Ahmed-Osama-v5/MBR-08/README.md

# MBR-08 — Modbus RTU Relay Module

> **8-channel relay output controller with Modbus RTU slave interface, built on STM32G0B1.**  
> Designed for industrial automation, building control, and IoT gateway integration via RS-485.

---

## Table of Contents

- [Overview](#overview)
- [Hardware](#hardware)
  - [MCU](#mcu)
  - [Peripherals](#peripherals)
- [Firmware Architecture](#firmware-architecture)
  - [Layer Structure](#layer-structure)
  - [Modbus RTU Implementation](#modbus-rtU-implementation)
  - [EEPROM Driver](#eeprom-driver)
- [Modbus Register Map](#modbus-register-map)
- [Communication Parameters](#communication-parameters)
- [Build](#build--flash)
  - [Prerequisites](#prerequisites)
  - [Building with STM32CubeIDE](#building-with-stm32cubeide)
- [Configuration](#configuration)
  - [Baud Rate Selection](#baud-rate-selection)
  - [Node Address](#node-address)
- [IoT Integration Example](#iot-integration-example)
- [Project Status](#project-status)
- [License](#license)

---

## Overview

The **MBR-08** is an open-source Modbus RTU slave relay module intended for use in:

- Industrial I/O panels (RS-485 bus control)
- Smart building automation (lighting, HVAC switching)
- DIY IoT gateways (e.g., Raspberry Pi + Node-RED + InfluxDB + Grafana stack)
- Lab automation and test bench control

The firmware is written in bare-metal C, targeting the STM32G0B1CBTx, with a clean MCAL → HAL → Application layered architecture and zero direct HAL calls inside module logic (all HAL access is abstracted behind compile-time macros for portability).

---

## Hardware

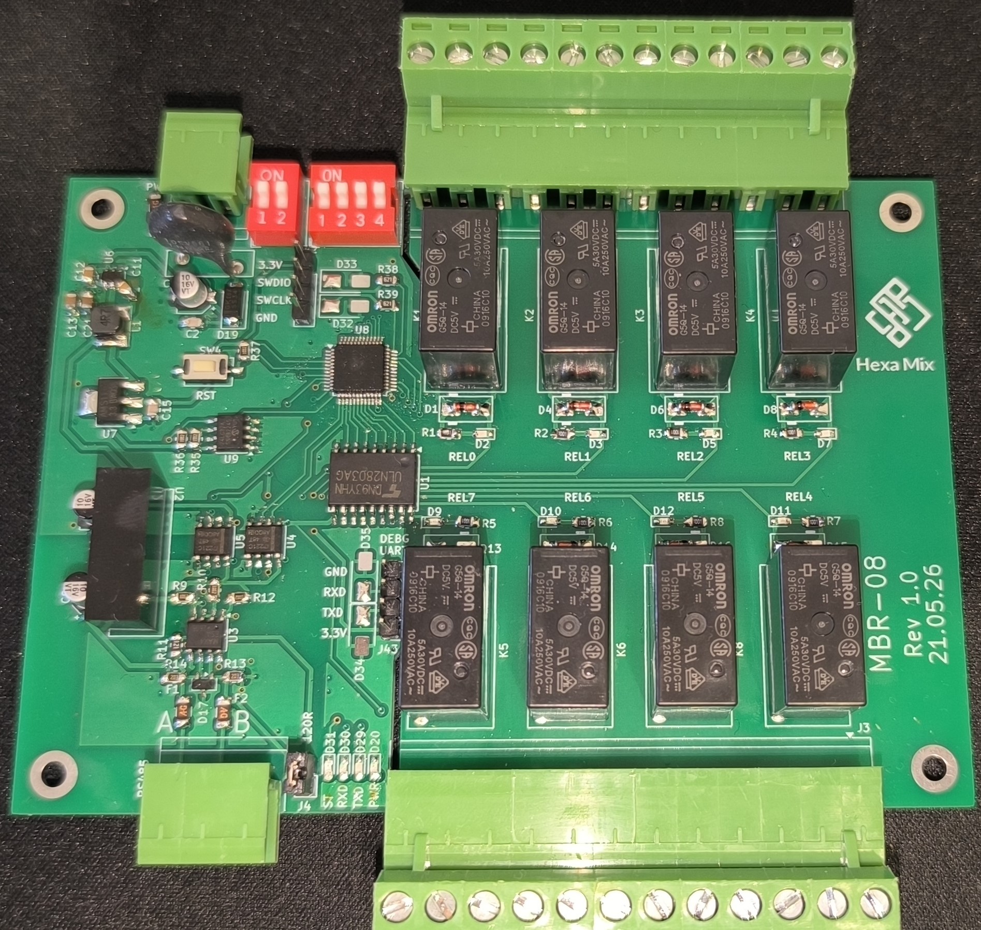
[picture p1: images/MBR-08_R1_0.jpg]
MBR-08


### MCU

| Parameter | Value |
|---|---|
| Part | STM32G0B1CBTx |
| Core | Arm Cortex-M0+, up to 64 MHz |
| Flash | 128 KB |
| RAM | 144 KB |
| Package | LQFP-48 |

### Peripherals

| Peripheral | Usage |
|---|---|
| USART1 | Modbus RTU (RS-485), configurable baud rate |
| LPTIM1 | Modbus 3.5T interframe silence detection |
| I2C1 | 24LC08 EEPROM (configuration persistence) |
| GPIO (8×) | Relay coil drive outputs |
| GPIO (n×) | Baud rate / node address DIP input pins |

---

## Firmware Architecture

### Layer Structure

```
Application (App/)
    │  Business logic: relay control
    │  Zero direct HAL calls — uses macro wrappers only
    ▼
HAL Abstraction (modbus_slave.h)
    │  modbus slave logic
    │  ...
    ▼
STM32 HAL / CMSIS (Drivers/)
    │  Generated by STM32CubeMX (.ioc file included)
    ▼
Hardware (STM32G0B1CBTx)
```

### Modbus RTU Implementation

- **Role:** Slave only
- **Interframe timing:** LPTIM1-based 3.5T detection (not software timer — accurate at all supported baud rates)
- **Supported function codes:**

  | FC   | Name                    | Direction |
  |------|-------------------------|-----------|
  | 0x01 | Read Coils              | Master → Slave (read) |
  | 0x05 | Write Single Coil       | Master → Slave (write) |
  | 0x0F | Write Multiple Coils    | Master → Slave (write) |
  | 0x03 | Read Holding Registers  | Master → Slave (read) |
  | 0x06 | Write Single Register   | Master → Slave (write) |
  | 0x10 | Write Multiple Registers   | Master → Slave (write) |

- **CRC:** Hardware-assisted or software CRC-16/IBM (Modbus polynomial `0xA001`)
- **RS-485 DE/RE:** GPIO-controlled direction pin, managed in UART TX complete callback

### EEPROM Driver

A three-file I2C EEPROM driver targets the **24LC08** (8 Kbit, 16-byte pages):

| File | Role |
|---|---|
| `i2c_eeprom_cfg.h` | Device address, page size, timeout config |
| `i2c_eeprom.h` | Public API declarations |
| `i2c_eeprom.c` | Implementation: read, write (page-aware), ACK poll |

Features:
- **Page-boundary-aware writes** — automatically splits writes that cross a 16-byte page boundary
- **ACK polling** after write cycles (no fixed delay)
- Follows the same Hungarian notation and module naming conventions used throughout the codebase

Persisted configuration includes: node address, baud rate index, relay power-on state.

---

## Modbus Register Map

### Holding Register Map 

| Address | Description | R/W | Range |
|---|---|-----|---|
| 0x0000  | Relay 1 (CH1) | R/W | 0xFF00 (Relay On), 0x0000 (Relay Off), 0xAA00 (Relay Toggle)
| 0x0001  | Relay 2 (CH2) | R/W |
| 0x0002  | Relay 3 (CH3) | R/W |
| 0x0003  | Relay 4 (CH4) | R/W |
| 0x0004  | Relay 5 (CH5) | R/W |
| 0x0005  | Relay 6 (CH6) | R/W |
| 0x0006  | Relay 7 (CH7) | R/W |
| 0x0007  | Relay 8 (CH8) | R/W |
| | | |
| 0x00FF  | All relays | R/W |
| | | |
| 0x0200  | Relay On delay (CH1) | R/W | value  * 100ms|
| 0x0201  | Relay On delay (CH2) | R/W | |
| 0x0202  | Relay On delay (CH3) | R/W | |
| 0x0203  | Relay On delay (CH4) | R/W | |
| 0x0204  | Relay On delay (CH5) | R/W | |
| 0x0205  | Relay On delay (CH6) | R/W | |
| 0x0206  | Relay On delay (CH7) | R/W | |
| 0x0207  | Relay On delay (CH8) | R/W | |
| | | |
| 0x0400  | Relay Off delay (CH1)  | R/W | value  * 100ms|
| 0x0401  | Relay Off delay (CH2)  | R/W | |
| 0x0402  | Relay Off delay (CH3)  | R/W | |
| 0x0403  | Relay Off delay (CH4)  | R/W | |
| 0x0404  | Relay Off delay (CH5)  | R/W | |
| 0x0405  | Relay Off delay (CH6)  | R/W | |
| 0x0406  | Relay Off delay (CH7)  | R/W | |
| 0x0407  | Relay Off delay (CH8)  | R/W | |
| | | |
| 0x2000  | UART parameters | R/W | TBD |
| | | |
| 0x3000  | Device address | R/W | 1 - 247 |
| | | |
| 0x4000  | Software version | R | 0x0064 = 100 = V1.00 |

---

## Communication Parameters

### Default Parameters

| Parameter | Default |
|---|---|
| Baud rate | 9600 bps |
| Data bits | 8 |
| Parity | None |
| Stop bits | 1 |
| Node address | 1 |

### Supported Baud Rates

| Index | Baud Rate  |
|---|---|
| 0 | 1200 |
| 1 | 2400 |
| 2 | 4800 |
| 3 | 9600 |
| 4 | 19200 |
| 5 | 38400 |
| 6 | 57600 |
| 7 | 115200 |

Baud rate is selected via GPIO input pins on boot (hardware DIP switches) and stored in EEPROM. Register-based runtime change is also supported (takes effect after reset).

---

## Build

### Prerequisites

| Tool | Version tested |
|---|---|
| STM32CubeIDE | 2.1.1 |
| STM32CubeMX | 6.17.0 (`.ioc` included) |
| arm-none-eabi-gcc | 10.3.1 |
| ST-Link V2 / V3 | Any |

### Building with STM32CubeIDE

```bash
# Clone the repository
git clone https://github.com/Ahmed-Osama-v5/MBR-08.git
cd MBR-08

# Open in STM32CubeIDE: File → Open Projects from File System
# Select the repo root directory
# Build: Project → Build All  (or Ctrl+B)
```

The `.cproject` and `.project` Eclipse CDT files are included. The build produces `MBR-08.elf` and `MBR-08.bin` under `Debug/` or `Release/`.

## Configuration

### Baud Rate Selection

Baud rate is read from dedicated GPIO input pins on startup. Pull the pins LOW/HIGH according to the baud rate index table above. The value is latched once during `Modbus_Init()` and written to EEPROM if changed (requires reset to take effect).

## IoT Integration Example

The MBR-08 has been validated against a **Raspberry Pi 5** acting as Modbus RTU master and IoT gateway:

```
[MBR-08] ←── RS-485 ──→ [USB-RS485 adapter] ──→ [RPi 5]
                                                      │
                                              Node-RED (Modbus TCP/RTU)
                                                      │
                                              InfluxDB 2.x
                                              (org: HexaMix, bucket: relay_states)
                                                      │
                                              Grafana Dashboard
```

Node-RED `node-red-contrib-modbus` nodes can poll coil states and write relay outputs directly. InfluxDB line protocol logging provides historical state tracking per channel.

---

## Project Status

| Area | Status |
|---|---|
| Firmware — Core Modbus RTU  | ✅ Complete |
| Firmware — EEPROM driver | ✅ Complete |
| Firmware — HAL abstraction macros | ✅ Complete |
| PCB — KiCad layout (BASE_8CH) | ✅ Complete |
| Unit tests | 📋 Planned |
| Hardware bring-up / validation | ✅ Complete |

---

## License

This project is dual-licensed:

- **Open-source use:** [GNU General Public License v3.0](LICENSE) — see `GPL-3.0.txt`
- **Commercial / proprietary use:** Contact the author for a commercial license

Third-party components (STM32 HAL, CMSIS) retain their original ST Microelectronics licenses as included in the `Drivers/` directory.

---

*Maintained by [Ahmed Osama](https://github.com/Ahmed-Osama-v5)*
