Ahmed-Osama-v5/MBR-08/MBR-08_sch.pdf

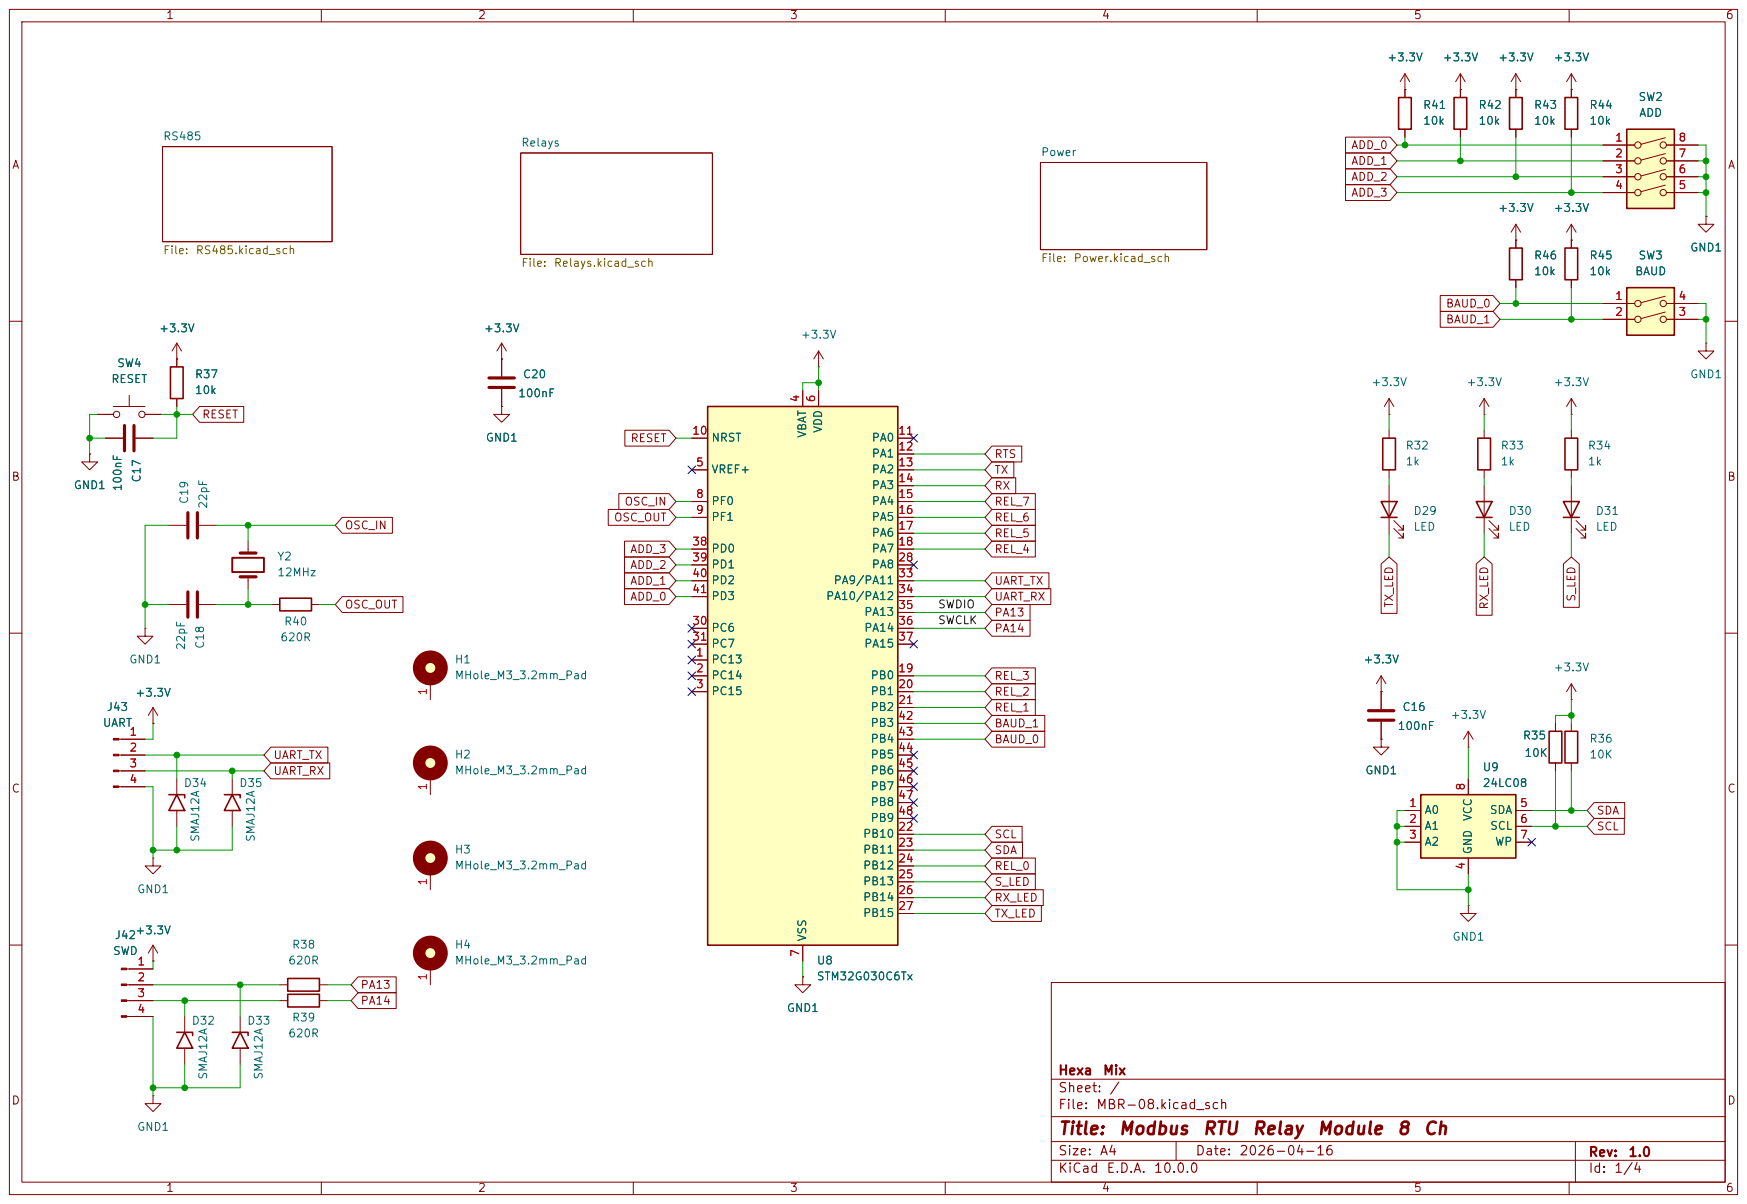
[picture p2: page 1]

Power File: Power.kicad_sch Relays

Hexa Mix
Sheet: /
D Date: 2026-04-16 KiCad E.D.A. 10.0.0
File: MBR-08.kicad_sch
Title: Modbus RTU Relay Module 8 Ch

Size: A4 | Rev: 1.0

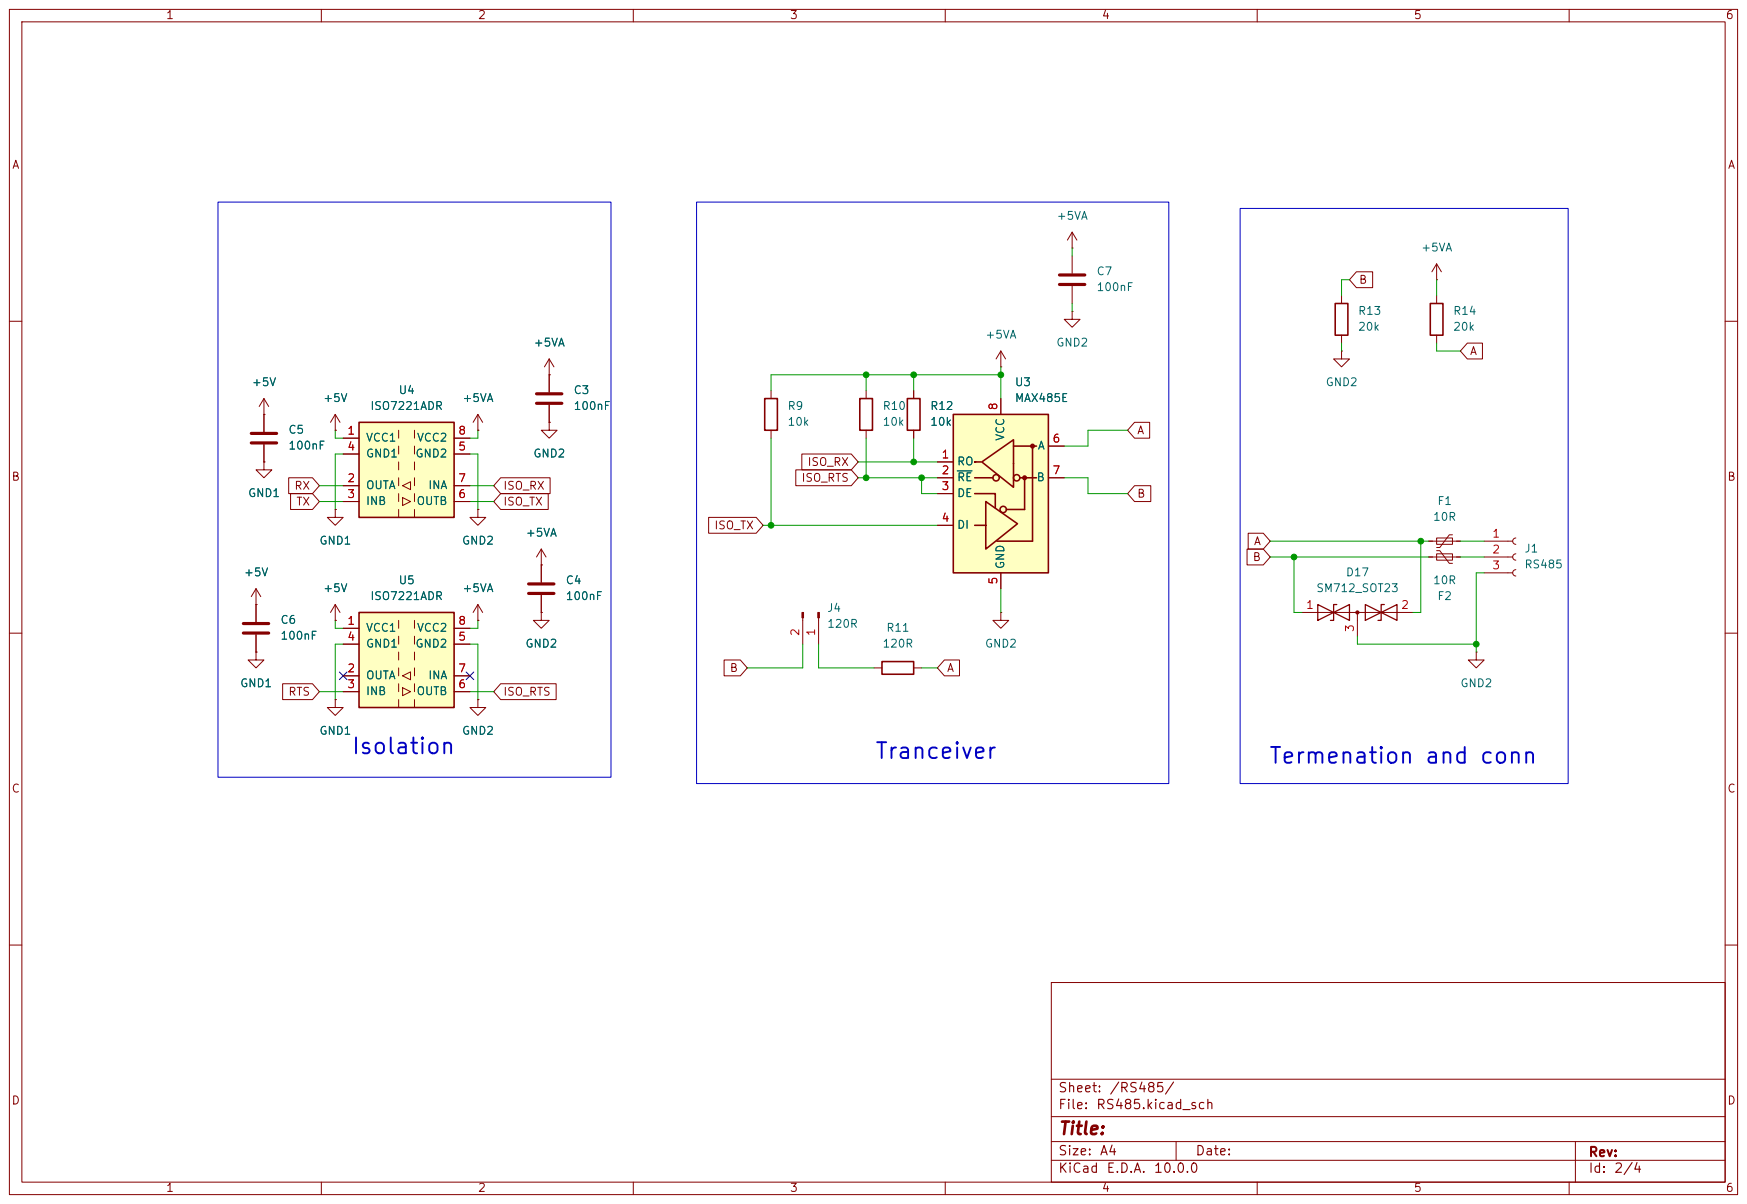
[picture p3: page 2]

Size: A4 | Rev:
KiCad E.D.A. 10.0.0

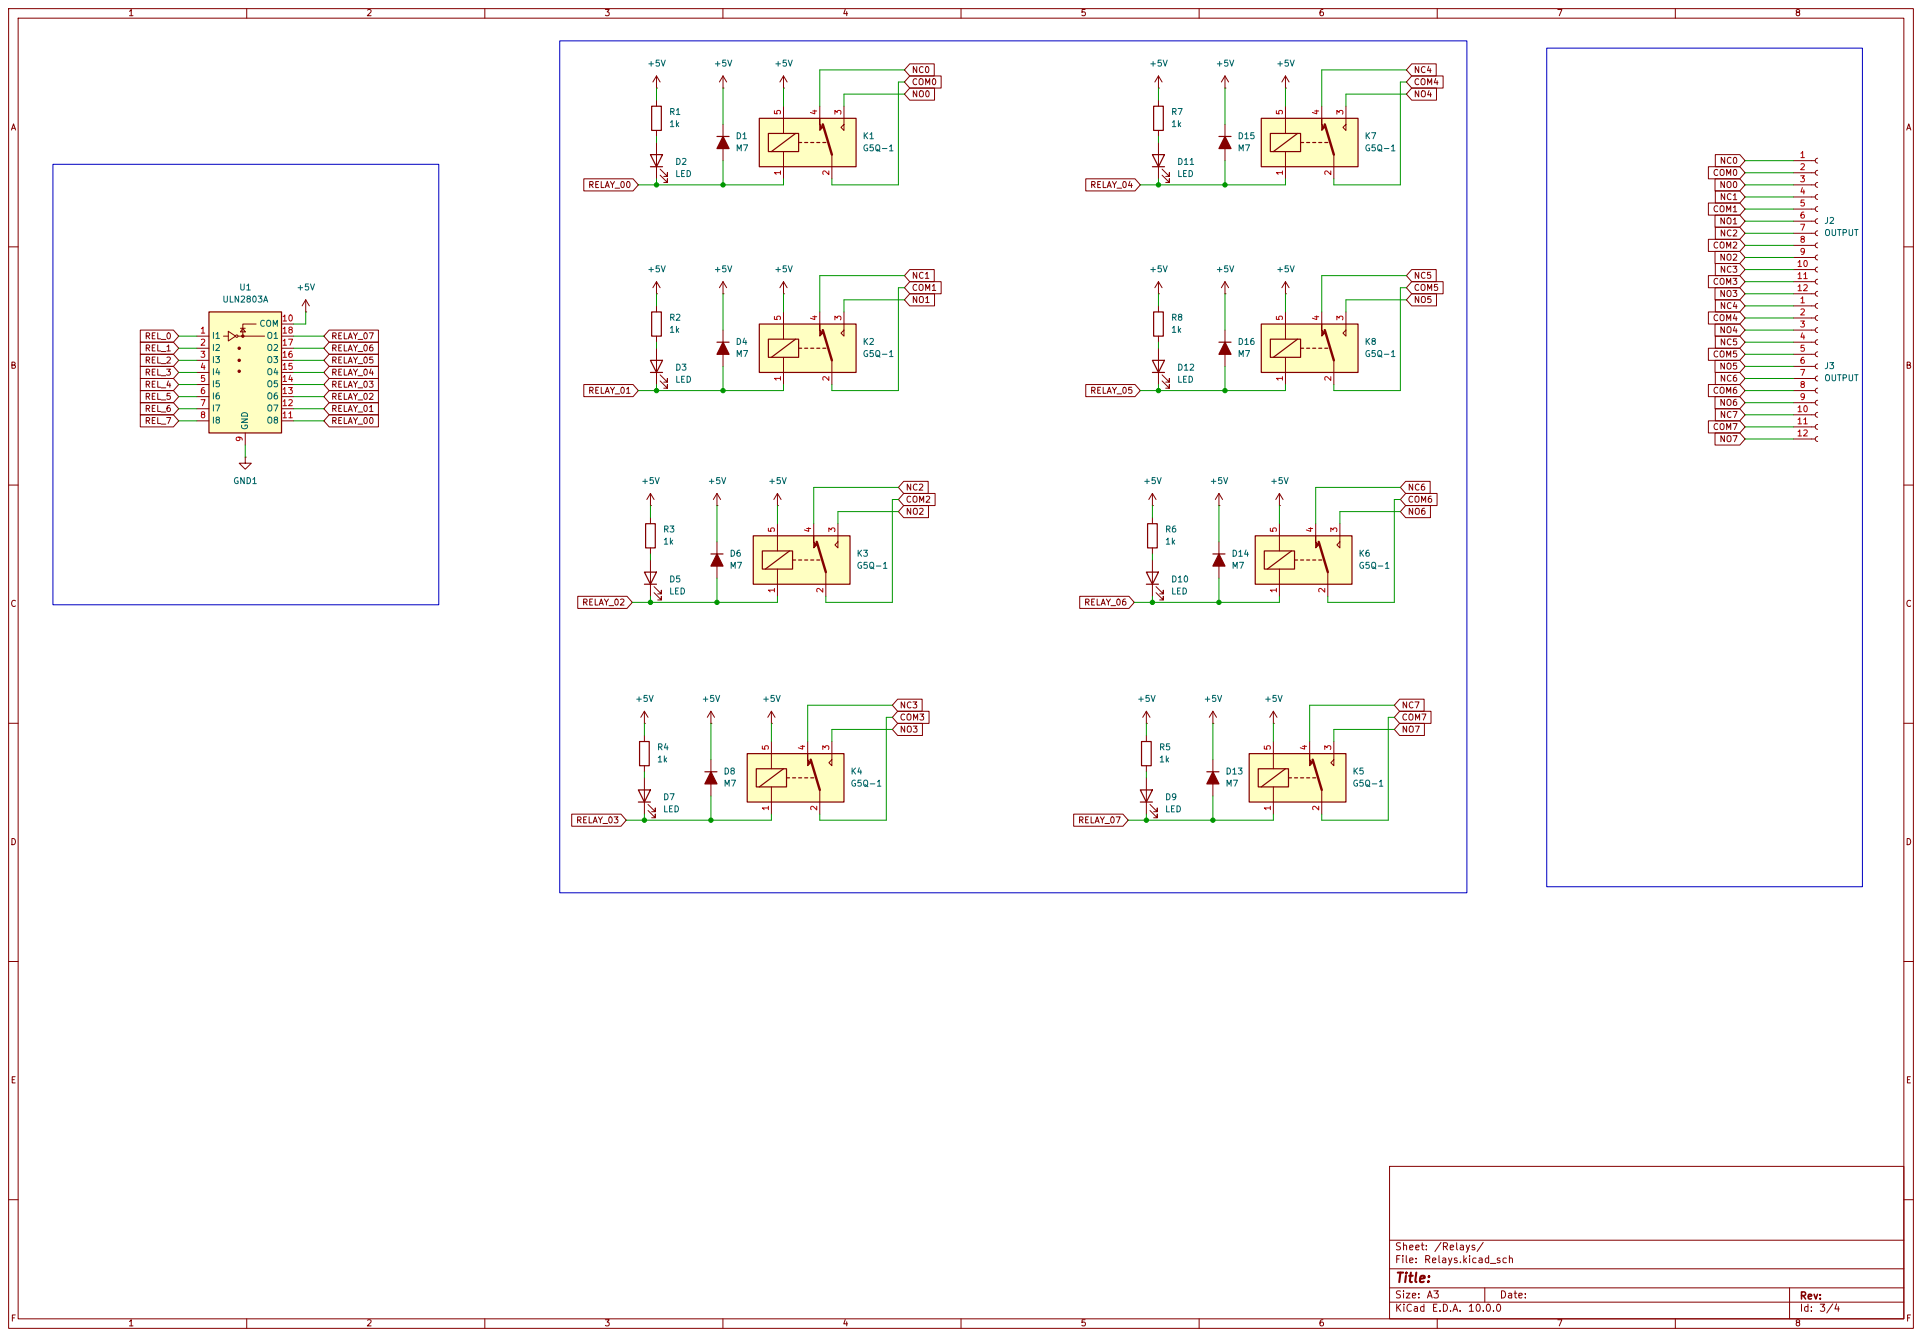
[picture p4: page 3]

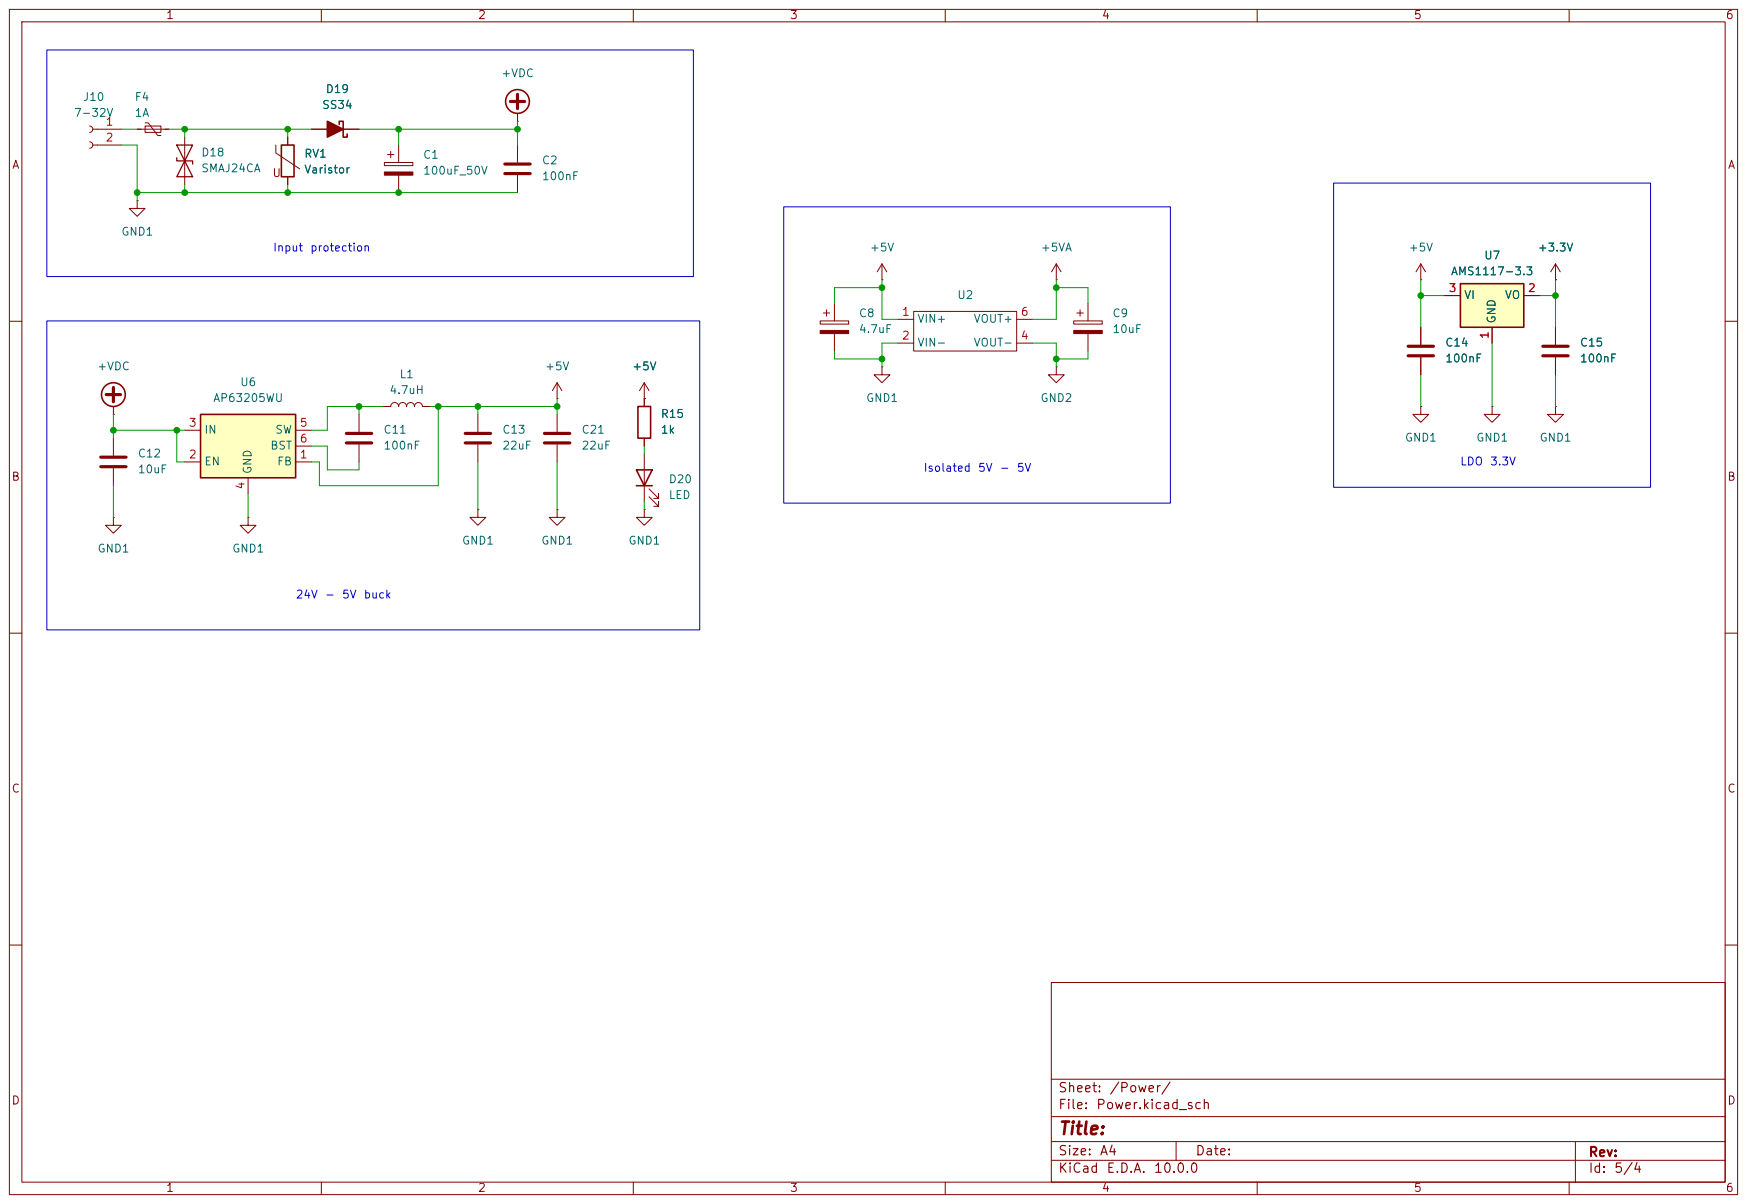
[picture p5: page 4]
