Ahmed-Osama-v5/MBR-08/Core/Src/main.c

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
/* Includes ------------------------------------------------------------------*/
#include "main.h"

/* USER CODE BEGIN Includes */
#include <stdbool.h>
#include "scheduler.h"
#include "modbus_slave.h"
/* USER CODE END Includes */

I2C_HandleTypeDef hi2c2;

IWDG_HandleTypeDef hiwdg;

TIM_HandleTypeDef htim2;

UART_HandleTypeDef huart1;
UART_HandleTypeDef huart2;

/* USER CODE BEGIN PV */

/* struct that holds all relay control registers */
extern Regs_t regsRelCon;

/* flag to indicate new data reception */
bool bNewData = true;
/* USER CODE END PV */

void SystemClock_Config(void);
static void MX_GPIO_Init(void);
static void MX_I2C2_Init(void);
static void MX_USART1_UART_Init(void);
static void MX_USART2_UART_Init(void);
static void MX_IWDG_Init(void);
static void MX_TIM2_Init(void);
/* USER CODE BEGIN PFP */

static void Task_RelayUpdate(void);
static void Task_ActLED(void);
/* USER CODE END PFP */

/**
  * @brief  The application entry point.
  * @retval int
  */
int main(void)
{

  /* MCU Configuration--------------------------------------------------------*/

  /* Reset of all peripherals, Initializes the Flash interface and the Systick. */
  HAL_Init();

  /* Configure the system clock */
  SystemClock_Config();

  /* Initialize all configured peripherals */
  MX_GPIO_Init();
  MX_I2C2_Init();
  MX_USART1_UART_Init();
  MX_USART2_UART_Init();
  MX_IWDG_Init();
  MX_TIM2_Init();
  /* USER CODE BEGIN 2 */
  Scheduler_Init();
  Modbus_Init();

  /* Turn TX led off */
  HAL_GPIO_WritePin(TX_LED_GPIO_Port, TX_LED_Pin, GPIO_PIN_SET);

  /* Turn RX led off */
  HAL_GPIO_WritePin(RX_LED_GPIO_Port, RX_LED_Pin, GPIO_PIN_SET);

  /* Note: Modbus has no tasks in the scheduler because it's all run through interrupts */
  Scheduler_AddTask(Task_RelayUpdate,     5U,   50U);  /* every 5ms,  stuck if >50ms  */
  Scheduler_AddTask(Task_ActLED,  500U,    0U);  /* every 500ms, not wdog-guarded */


  uint8_t msg[] = "Start scheduler\r\n";
  HAL_UART_Transmit(&huart1, msg, sizeof(msg) - 1, HAL_MAX_DELAY);
  /* USER CODE END 2 */

  /* Infinite loop */
  /* USER CODE BEGIN WHILE */
  while (1)
  {
	  Scheduler_Run();
    /* USER CODE END WHILE */

    /* USER CODE BEGIN 3 */
  }
  /* USER CODE END 3 */
}

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
/* USER CODE BEGIN 4 */

/* Mirrors g_relay_coils bitmask to 8 GPIO relay outputs */
static void Task_RelayUpdate(void)
{
	if(bNewData)
	{
		for (uint8_t ch = 0U; ch < MB_NUM_COILS; ch++) {
			GPIO_PinState state = (regsRelCon.pRegs[ch]->u16Data == cu16_RELAY_ON) ? GPIO_PIN_SET : GPIO_PIN_RESET;

			switch (ch) {
				case 0: HAL_GPIO_WritePin(REL_0_GPIO_Port, REL_0_Pin, state); break;
				case 1: HAL_GPIO_WritePin(REL_1_GPIO_Port, REL_1_Pin, state); break;
				case 2: HAL_GPIO_WritePin(REL_2_GPIO_Port, REL_2_Pin, state); break;
				case 3: HAL_GPIO_WritePin(REL_3_GPIO_Port, REL_3_Pin, state); break;
				case 4: HAL_GPIO_WritePin(REL_4_GPIO_Port, REL_4_Pin, state); break;
				case 5: HAL_GPIO_WritePin(REL_5_GPIO_Port, REL_5_Pin, state); break;
				case 6: HAL_GPIO_WritePin(REL_6_GPIO_Port, REL_6_Pin, state); break;
				case 7: HAL_GPIO_WritePin(REL_7_GPIO_Port, REL_7_Pin, state); break;
				default: break;
			}
		}
	}
	bNewData = false;

}

static void Task_ActLED(void)
{
    HAL_GPIO_TogglePin(ACT_LED_GPIO_Port, ACT_LED_Pin);
}

/**
 * @brief UART RX complete — fires for every received byte.
 */
void HAL_UART_RxCpltCallback(UART_HandleTypeDef *huart)
{
    if (huart->Instance == USART2)
    {
        /* s_rxBuf[s_rxLen-1] already written by HAL into the pointer we gave.
           We need to extract the last byte — simplest: keep a shadow byte.   */
        extern uint8_t g_lastRxByte;   /* defined in modbus_slave.c below    */
        Modbus_RxByteCallback(g_lastRxByte);
    }
}

/**
 * @brief TIM2 period elapsed — 3.5T silence detected.
 */
void HAL_TIM_PeriodElapsedCallback(TIM_HandleTypeDef *htim)
{
	if (htim->Instance == TIM2)
	{
		ModbusTimer_FrameDoneCallback();
	}
}

/* USER CODE END 4 */
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
