Ahmed-Osama-v5/MBR-08/Core/Inc/main.h

#define cu16SOFTWARE_VERSION	((uint16_t) 100u)
#define MODBUS_UART_CH	huart2
#define MODBUS_TIMER_CH	htim2
#define RX_EN_Pin GPIO_PIN_1
#define RX_EN_GPIO_Port GPIOA
#define REL_7_Pin GPIO_PIN_4
#define REL_7_GPIO_Port GPIOA
#define REL_6_Pin GPIO_PIN_5
#define REL_6_GPIO_Port GPIOA
#define REL_5_Pin GPIO_PIN_6
#define REL_5_GPIO_Port GPIOA
#define REL_4_Pin GPIO_PIN_7
#define REL_4_GPIO_Port GPIOA
#define REL_3_Pin GPIO_PIN_0
#define REL_3_GPIO_Port GPIOB
#define REL_2_Pin GPIO_PIN_1
#define REL_2_GPIO_Port GPIOB
#define REL_1_Pin GPIO_PIN_2
#define REL_1_GPIO_Port GPIOB
#define REL_0_Pin GPIO_PIN_12
#define REL_0_GPIO_Port GPIOB
#define ACT_LED_Pin GPIO_PIN_13
#define ACT_LED_GPIO_Port GPIOB
#define RX_LED_Pin GPIO_PIN_14
#define RX_LED_GPIO_Port GPIOB
#define TX_LED_Pin GPIO_PIN_15
#define TX_LED_GPIO_Port GPIOB
#define ADD_3_Pin GPIO_PIN_0
#define ADD_3_GPIO_Port GPIOD
#define ADD_2_Pin GPIO_PIN_1
#define ADD_2_GPIO_Port GPIOD
#define ADD_1_Pin GPIO_PIN_2
#define ADD_1_GPIO_Port GPIOD
#define ADD_0_Pin GPIO_PIN_3
#define ADD_0_GPIO_Port GPIOD
#define BAUD_1_Pin GPIO_PIN_3
#define BAUD_1_GPIO_Port GPIOB
#define BAUD_0_Pin GPIO_PIN_4
#define BAUD_0_GPIO_Port GPIOB
