Ahmed-Osama-v5/MBR-08/Core/Src/modbus_slave.c

/**
 *
 * Copyright (C) 2026 HexaMix
 * SPDX-License-Identifier: GPL-3.0-only
 * Dual-licensed — see LICENSE for commercial use.
 *
 * @file    modbus_slave.c
 * @brief   Minimal Modbus RTU Slave — STM32G0B1CB
 *
 * Supported Function Codes:
 *   0x01 — Read Coils            (coils 0..7 )
 *   0x05 — Write Single Coil
 *   0x0F — Write Multiple Coils
 *   0x03 — Read Holding Registers (regs 0..7, shadow of coils)
 *   0x06 — Write Single Register
 *   0x10 — Write Multiple Registers
 *
 * Frame flow:
 *   UART RX byte → Modbus_RxByteCallback() → buffer + restart timer
 *   timer fires  → Modbus_TimerCallback()  → process frame → send response
 */

#include <stdio.h>
#include <string.h>
#include <stdbool.h>
#include "modbus_slave.h"
#include "i2c_eeprom.h"

#define _DEBUG


extern UART_HandleTypeDef huart1;

/* ── Coils status ───────────────────────────────────────────────────────── */
Coil_Status_t str_CoilStates;
extern bool bNewData;

/* ── Modbus exception codes ─────────────────────────────────────────────── */
#define MB_EX_ILLEGAL_FUNCTION      0x01u
#define MB_EX_ILLEGAL_DATA_ADDRESS  0x02u
#define MB_EX_ILLEGAL_DATA_VALUE    0x03u


/* ── Holding registers ───────────────────────────────────────────────────── */
/* Relay channels */
/* 0x0000 - 0x0007 channels 0..7
 * Permission: R/W
 * Functions: 0x01, 0x05, 0x0F
 * Values:
 * 0xFF00: relay on
 * 0x0000: relay off
 * 0xAA00: relay toggle
 * */
Reg_t regRelayCon0;
Reg_t regRelayCon1;
Reg_t regRelayCon2;
Reg_t regRelayCon3;
Reg_t regRelayCon4;
Reg_t regRelayCon5;
Reg_t regRelayCon6;
Reg_t regRelayCon7;

/* struct that holds all relay control registers */
Regs_t regsRelCon;

/* 0x00FF controls all relays
 * Permission: W
 * Functions: 0x05
 * Values:
 * 0xFF00: all relays on
 * 0x0000: all relays off
 * 0xAA00: all relays toggle
 * */
Reg_t regRelayConAll;

/* 0x0200 - 0x0207 relay on delay
 * Permission: W
 * Functions: 0x05
 * Values:
 * 0x0005: 5 * 100ms
 * */
Reg_t regRelayDelOn0;
Reg_t regRelayDelOn1;
Reg_t regRelayDelOn2;
Reg_t regRelayDelOn3;
Reg_t regRelayDelOn4;
Reg_t regRelayDelOn5;
Reg_t regRelayDelOn6;
Reg_t regRelayDelOn7;

/* struct that holds all relay on delay registers */
Regs_t regsRelDelOn;

/* 0x0400 - 0x407 relay off delay
 * Permission: W
 * Functions: 0x05
 * Values:
 * 0x0005: 5 * 100ms
 * */
Reg_t regRelayDelOff0;
Reg_t regRelayDelOff1;
Reg_t regRelayDelOff2;
Reg_t regRelayDelOff3;
Reg_t regRelayDelOff4;
Reg_t regRelayDelOff5;
Reg_t regRelayDelOff6;
Reg_t regRelayDelOff7;

/* struct that holds all relay off delay registers */
Regs_t regsRelDelOff;

/* 0x2000 UART parameters
 * Permission: R/W
 * Functions: 0x03, 0x06
 * Values:
 * The high eight bits indicate the parity mode: 0x00~0x02
 * The low eight bits indicate the baud rate mode: 0x00~0x07
 * */
Reg_t regUART_Param;

/* 0x3000 Device address
 * Permission: R/W
 * Functions: 0x03, 0x06
 * Values:
 * Directly store Modbus address
 * Device address: 0x0001-0x00F7
 * Based on DIP switch config:
 * 0000: defaults to memory stored address (default: 0x01)
 * 0001 - 1111 : address: 0x01 - 0x0F
 * */
Reg_t regDevAdd;

/* 0x4000 Software version
 * Permission: R
 * Functions: 0x03
 * Values:
 * Converting to decimal and then shifting the decimal point
 * two places to the left will represent the software version
 * 0x0064 = 100 = V1.00
 * refer to cu16SOFTWARE_VERSION in main.h
 * */
Reg_t regSWVer;



/* ── internal state ─────────────────────────────────────────────────────── */

static uint8_t  s_rxBuf[MB_RX_BUF_SIZE];
static uint16_t s_rxLen;
       uint8_t  g_lastRxByte;   /* HAL writes here; exposed to main.c       */
static uint8_t  s_txBuf[MB_TX_BUF_SIZE];

int __io_putchar(int ch)
{
    HAL_UART_Transmit(&huart1, (uint8_t *)&ch, 1, HAL_MAX_DELAY);
    return ch;
}


/* ── CRC-16 (Modbus polynomial 0xA001) ─────────────────────────────────── */
static uint16_t crc16(const uint8_t *buf, uint16_t len)
{
    uint16_t crc = 0xFFFFu;
    for (uint16_t i = 0u; i < len; i++)
    {
        crc ^= (uint16_t)buf[i];
        for (uint8_t b = 0u; b < 8u; b++)
        {
            if (crc & 0x0001u)
                crc = (crc >> 1u) ^ 0xA001u;
            else
                crc >>= 1u;
        }
    }
    return crc;
}

/* ── response helpers ───────────────────────────────────────────────────── */
static void sendResponse(uint16_t len)
{
	/* Turn TX led on */
	HAL_GPIO_WritePin(TX_LED_GPIO_Port, TX_LED_Pin, GPIO_PIN_RESET);

    uint16_t crc = crc16(s_txBuf, len);
    s_txBuf[len]     = (uint8_t)(crc & 0xFFu);         /* CRC low           */
    s_txBuf[len + 1u] = (uint8_t)((crc >> 8u) & 0xFFu); /* CRC high         */
    RS485_DE_HIGH();   // ← assert DE/RE before TX
    //HAL_UART_Transmit_IT(MODBUS_UART_HANDLE, s_txBuf, len + 2u);
    HAL_UART_Transmit_IT(&huart2, s_txBuf, len + 2u);
}

static void sendException(uint8_t fc, uint8_t exCode)
{
    s_txBuf[0] = regDevAdd.u16Data;
    s_txBuf[1] = fc | 0x80u;
    s_txBuf[2] = exCode;
    sendResponse(3u);
}

static bool bIsAddValid(uint16_t regAdd)
{
	if((regAdd == cu16RELAY_CON_CH_0_ADD)
			|| (regAdd == cu16RELAY_CON_CH_1_ADD)
			|| (regAdd == cu16RELAY_CON_CH_2_ADD)
			|| (regAdd == cu16RELAY_CON_CH_3_ADD)
			|| (regAdd == cu16RELAY_CON_CH_4_ADD)
			|| (regAdd == cu16RELAY_CON_CH_5_ADD)
			|| (regAdd == cu16RELAY_CON_CH_6_ADD)
			|| (regAdd == cu16RELAY_CON_CH_7_ADD)
			|| (regAdd == cu16RELAY_CON_ALL_ADD)
			|| (regAdd == cu16RELAY_ON_DELAY_CH_0_ADD)
			|| (regAdd == cu16RELAY_ON_DELAY_CH_1_ADD)
			|| (regAdd == cu16RELAY_ON_DELAY_CH_2_ADD)
			|| (regAdd == cu16RELAY_ON_DELAY_CH_3_ADD)
			|| (regAdd == cu16RELAY_ON_DELAY_CH_4_ADD)
			|| (regAdd == cu16RELAY_ON_DELAY_CH_5_ADD)
			|| (regAdd == cu16RELAY_ON_DELAY_CH_6_ADD)
			|| (regAdd == cu16RELAY_ON_DELAY_CH_7_ADD)
			|| (regAdd == cu16RELAY_OFF_DELAY_CH_0_ADD)
			|| (regAdd == cu16RELAY_OFF_DELAY_CH_1_ADD)
			|| (regAdd == cu16RELAY_OFF_DELAY_CH_2_ADD)
			|| (regAdd == cu16RELAY_OFF_DELAY_CH_3_ADD)
			|| (regAdd == cu16RELAY_OFF_DELAY_CH_4_ADD)
			|| (regAdd == cu16RELAY_OFF_DELAY_CH_5_ADD)
			|| (regAdd == cu16RELAY_OFF_DELAY_CH_6_ADD)
			|| (regAdd == cu16RELAY_OFF_DELAY_CH_7_ADD)
			|| (regAdd == cu16UART_PARAM_ADD)
			|| (regAdd == cu16DEVICE_ADDRESS_ADD)
			|| (regAdd == cu16SOFTWARE_VERSION_ADD))
	{
		return true;
	}
	return false;
}

/**
 * @brief iterates through register addresses
 * and returns pointer to required register address
 * @param u16Addr
 * @return (Reg_t*) pointer to required register address
 */
static Reg_t* pFindReg(uint16_t u16Addr)
{
	if(u16Addr == cu16RELAY_CON_CH_0_ADD)
		return &regRelayCon0;
	else if(u16Addr == cu16RELAY_CON_CH_1_ADD)
		return &regRelayCon1;
	else if(u16Addr == cu16RELAY_CON_CH_2_ADD)
		return &regRelayCon2;
	else if(u16Addr == cu16RELAY_CON_CH_3_ADD)
		return &regRelayCon3;
	else if(u16Addr == cu16RELAY_CON_CH_4_ADD)
		return &regRelayCon4;
	else if(u16Addr == cu16RELAY_CON_CH_5_ADD)
		return &regRelayCon5;
	else if(u16Addr == cu16RELAY_CON_CH_6_ADD)
		return &regRelayCon6;
	else if(u16Addr == cu16RELAY_CON_CH_7_ADD)
		return &regRelayCon7;

	else if(u16Addr == cu16RELAY_CON_ALL_ADD)
		return &regRelayConAll;

	else if(u16Addr == cu16RELAY_ON_DELAY_CH_0_ADD)
		return &regRelayDelOn0;
	else if(u16Addr == cu16RELAY_ON_DELAY_CH_1_ADD)
		return &regRelayDelOn1;
	else if(u16Addr == cu16RELAY_ON_DELAY_CH_2_ADD)
		return &regRelayDelOn2;
	else if(u16Addr == cu16RELAY_ON_DELAY_CH_3_ADD)
		return &regRelayDelOn3;
	else if(u16Addr == cu16RELAY_ON_DELAY_CH_4_ADD)
		return &regRelayDelOn4;
	else if(u16Addr == cu16RELAY_ON_DELAY_CH_5_ADD)
		return &regRelayDelOn5;
	else if(u16Addr == cu16RELAY_ON_DELAY_CH_6_ADD)
		return &regRelayDelOn6;
	else if(u16Addr == cu16RELAY_ON_DELAY_CH_7_ADD)
		return &regRelayDelOn7;

	else if(u16Addr == cu16RELAY_OFF_DELAY_CH_0_ADD)
		return &regRelayDelOff0;
	else if(u16Addr == cu16RELAY_OFF_DELAY_CH_1_ADD)
		return &regRelayDelOff1;
	else if(u16Addr == cu16RELAY_OFF_DELAY_CH_2_ADD)
		return &regRelayDelOff2;
	else if(u16Addr == cu16RELAY_OFF_DELAY_CH_3_ADD)
		return &regRelayDelOff3;
	else if(u16Addr == cu16RELAY_OFF_DELAY_CH_4_ADD)
		return &regRelayDelOff4;
	else if(u16Addr == cu16RELAY_OFF_DELAY_CH_5_ADD)
		return &regRelayDelOff5;
	else if(u16Addr == cu16RELAY_OFF_DELAY_CH_6_ADD)
		return &regRelayDelOff6;
	else if(u16Addr == cu16RELAY_OFF_DELAY_CH_7_ADD)
		return &regRelayDelOff7;

	else if(u16Addr == cu16UART_PARAM_ADD)
		return &regUART_Param;

	else if(u16Addr == cu16DEVICE_ADDRESS_ADD)
		return &regDevAdd;

	else
		return NULL;
}

#if 0
static uint16_t u16GetRegEE_Addr(const Reg_t* pReg)
{
	uint16_t u16RetVal = 0x00FF;

	if(pReg == &regUART_Param)
		u16RetVal = cu16UART_PARAM_EE_ADD;

	if(pReg == &regDevAdd)
		u16RetVal = cu16DEVICE_ADDRESS_EE_ADD;

	return u16RetVal;
}
#endif

/* ── FC 0x01 — Read Coils ───────────────────────────────────────────────── */
static void fc01_readCoils(void)
{
    uint16_t startAddr = ((uint16_t)s_rxBuf[2] << 8u) | s_rxBuf[3];
    uint16_t quantity  = ((uint16_t)s_rxBuf[4] << 8u) | s_rxBuf[5];

    if (quantity == 0u || quantity > MB_NUM_COILS)
    {
        sendException(0x01u, MB_EX_ILLEGAL_DATA_VALUE);
        return;
    }
    for(uint16_t i = 0;i<quantity;i++)
    {
    	if(! bIsAddValid(startAddr + i))
    	{
    		sendException(0x01u, MB_EX_ILLEGAL_DATA_ADDRESS);
    		return;
    	}
    }

    uint8_t byteCount = (uint8_t)((quantity + 7u) / 8u);
    s_txBuf[0] = regDevAdd.u16Data;
    s_txBuf[1] = 0x01u;
    s_txBuf[2] = byteCount;

    /* zero out data bytes first */
    for (uint8_t i = 0u; i < byteCount; i++)
    {
    	s_txBuf[3u + i] = 0x00u;
    }

	/* Pack coil states — LSB of first byte = coil at startAddr */
	for (uint16_t i = 0u; i < quantity; i++)
	{
		/* Any non-zero value considered COIL = ON */
		if (regsRelCon.pRegs[(startAddr-(cu16RELAY_CON_CH_0_ADD)) + i]->u16Data != 0x0000)
			s_txBuf[3u + (i / 8u)] |= (uint8_t)(1u << (i % 8u));
	}

    sendResponse(3u + byteCount);
}

/* ── FC 0x05 — Write Single Coil ────────────────────────────────────────── */
static void fc05_writeSingleCoil(void)
{
    uint16_t addr  = ((uint16_t)s_rxBuf[2] << 8u) | s_rxBuf[3];
    uint16_t value = ((uint16_t)s_rxBuf[4] << 8u) | s_rxBuf[5];

    if (addr >= MB_NUM_COILS)
    {
        sendException(0x05u, MB_EX_ILLEGAL_DATA_ADDRESS);
        return;
    }
    if (value != cu16_RELAY_OFF && value != cu16_RELAY_ON && value !=cu16_RELAY_TOGGLE)
    {
        sendException(0x05u, MB_EX_ILLEGAL_DATA_VALUE);
        return;
    }

    /* Write value to register */
    regsRelCon.pRegs[addr]->u16Data = (value == cu16_RELAY_ON) ? cu16_RELAY_ON : cu16_RELAY_OFF;

    // sync value with app layer
	bNewData = true;

    /* echo request as response */
    memcpy(s_txBuf, s_rxBuf, 6u);
    sendResponse(6u);
}

/* ── FC 0x0F — Write Multiple Coils ─────────────────────────────────────── */
static void fc0F_writeMultipleCoils(void)
{
    uint16_t startAddr = ((uint16_t)s_rxBuf[2] << 8u) | s_rxBuf[3];
    uint16_t quantity  = ((uint16_t)s_rxBuf[4] << 8u) | s_rxBuf[5];

    if (quantity == 0u || quantity > MB_NUM_COILS)
    {
        sendException(0x0Fu, MB_EX_ILLEGAL_DATA_VALUE);
        return;
    }
    for(uint16_t i = 0;i<quantity;i++)
	{
		if(! bIsAddValid(startAddr + i))
		{
			sendException(0x01u, MB_EX_ILLEGAL_DATA_ADDRESS);
			return;
		}
	}

    for (uint16_t i = 0u; i < quantity; i++)
    {
        uint8_t byteIdx = (uint8_t)(i / 8u);
        uint8_t bitIdx  = (uint8_t)(i % 8u);
        regsRelCon.pRegs[startAddr + i]->u16Data =
            ((s_rxBuf[7u + byteIdx] >> bitIdx) & 0x01u) ? cu16_RELAY_ON : cu16_RELAY_OFF;
    }

    // sync value with app layer
	bNewData = true;

    s_txBuf[0] = regDevAdd.u16Data;
    s_txBuf[1] = 0x0Fu;
    s_txBuf[2] = s_rxBuf[2];
    s_txBuf[3] = s_rxBuf[3];
    s_txBuf[4] = s_rxBuf[4];
    s_txBuf[5] = s_rxBuf[5];
    sendResponse(6u);
}

/* ── FC 0x03 — Read Holding Registers ───────────────────────────────────── */
static void fc03_readHoldingRegs(void)
{
    uint16_t startAddr = ((uint16_t)s_rxBuf[2] << 8u) | s_rxBuf[3];
    uint16_t quantity  = ((uint16_t)s_rxBuf[4] << 8u) | s_rxBuf[5];

    if (quantity == 0u || quantity > MB_NUM_REGS)
    {
#ifdef _DEBUG
    	printf("FC03 err, quantity: %d\r\n", quantity);
#endif
        sendException(0x03u, MB_EX_ILLEGAL_DATA_VALUE);
        return;
    }
    for(uint16_t i = 0;i<quantity;i++)
    {
    	if(! bIsAddValid(startAddr + i))
    	{
#ifdef _DEBUG
        	printf("FC03 err, add err: %d\r\n", startAddr);
#endif
    		sendException(0x01u, MB_EX_ILLEGAL_DATA_ADDRESS);
    		return;
    	}
    }

    uint8_t byteCount = (uint8_t)(quantity * 2u);
    s_txBuf[0] = regDevAdd.u16Data;
    s_txBuf[1] = 0x03u;
    s_txBuf[2] = byteCount;

    /* zero out data bytes first */
    for (uint8_t i = 0u; i < byteCount; i++)
        s_txBuf[3u + i] = 0x00u;

    /* Coil states */
	if((startAddr >= cu16RELAY_CON_CH_0_ADD) && (startAddr <= cu16RELAY_CON_CH_7_ADD))
	{
#ifdef _DEBUG
    	printf("FC03, reading coil: %d state\r\n", startAddr);
#endif
		/* Pack coil states — LSB of first byte = coil at startAddr */
		for (uint16_t i = 0u; i < quantity; i++)
		{
			/* Any non-zero value considered COIL = ON */
			if (regsRelCon.pRegs[(startAddr-(cu16RELAY_CON_CH_0_ADD)) + i]->u16Data != 0x0000)
				s_txBuf[3u + (i / 8u)] |= (uint8_t)(1u << (i % 8u));
		}
	}
	/* UART parameters */
	else if(startAddr == cu16UART_PARAM_ADD)
	{
#ifdef _DEBUG
    	printf("FC03, reading uart: %d\r\n", startAddr);
#endif
		// Low
		s_txBuf[3u] = (uint8_t)regUART_Param.u16Data;
		// High
		s_txBuf[4u] = (uint8_t)(regUART_Param.u16Data >> 8);
	}
	/* Device address */
	else if(startAddr == cu16DEVICE_ADDRESS_ADD)
	{
#ifdef _DEBUG
    	printf("FC03, reading dev addr: %d\r\n", startAddr);
#endif
		// Low
		s_txBuf[3u] = (uint8_t)regDevAdd.u16Data;
		// High
		s_txBuf[4u] = (uint8_t)(regDevAdd.u16Data >> 8);
	}

	/* SW version */
	else if(startAddr == cu16SOFTWARE_VERSION_ADD)
	{
#ifdef _DEBUG
    	printf("FC03, reading sw ver: %d\r\n", startAddr);
#endif
		// Low
		s_txBuf[3u] = (uint8_t)regSWVer.u16Data;
		// High
		s_txBuf[4u] = (uint8_t)(regSWVer.u16Data >> 8);
	}
	else
	{
		/* Do nothing */
	}

    sendResponse(3u + byteCount);
}

/* ── FC 0x06 — Write Single Register ────────────────────────────────────── */
static void fc06_writeSingleReg(void)
{
    uint16_t addr  = ((uint16_t)s_rxBuf[2] << 8u) | s_rxBuf[3];
    uint16_t value = ((uint16_t)s_rxBuf[4] << 8u) | s_rxBuf[5];

    if(! bIsAddValid(addr))
	{
		sendException(0x01u, MB_EX_ILLEGAL_DATA_ADDRESS);
		return;
	}

    Reg_t* pTmpReg = pFindReg(addr);
	if(pTmpReg != NULL)
	{
		pTmpReg->u16Data = value;

		/* store data to EEPROM only if addr other than control registers */
		if(addr > cu16RELAY_CON_ALL_ADD)
		{
			uint8_t au8Tmp[2];
			if(pTmpReg == &regUART_Param)
			{
				au8Tmp[0] = (uint8_t) pTmpReg->u16Data;
				au8Tmp[1] = (uint8_t) (pTmpReg->u16Data >> 8);

				if(EEPROM_enuWrite(cu16UART_PARAM_EE_ADD, au8Tmp, 2) == EEPROM_OK)
				{
					/* EEPROM write success */
				}
				else
				{
					/* TODO: handle this error */
				}
			}
			else if(pTmpReg == &regDevAdd)
			{
				au8Tmp[0] = (uint8_t) pTmpReg->u16Data;
				au8Tmp[1] = (uint8_t) (pTmpReg->u16Data >> 8);

				if(EEPROM_enuWrite(cu16DEVICE_ADDRESS_EE_ADD, au8Tmp, 2) == EEPROM_OK)
				{
					/* EEPROM write success */
				}
				else
				{
					/* TODO: handle this error */
				}
			}
			else
			{
				/* Ignore */
			}
		}
	}

    if((addr >= cu16RELAY_CON_CH_0_ADD) && (addr <= cu16RELAY_CON_CH_7_ADD))
    {
        // sync value with app layer
    	bNewData = true;
    }
    if(addr == cu16RELAY_CON_ALL_ADD)
    {
    	/* control all relays */
    	for (uint8_t ch = 0U; ch < MB_NUM_COILS; ch++)
    		regsRelCon.pRegs[ch]->u16Data = pTmpReg->u16Data;

        // sync value with app layer
    	bNewData = true;
    }

    memcpy(s_txBuf, s_rxBuf, 6u);
    sendResponse(6u);
}

/* ── FC 0x10 — Write Multiple Registers ─────────────────────────────────── */
static void fc10_writeMultipleRegs(void)
{
    uint16_t startAddr = ((uint16_t)s_rxBuf[2] << 8u) | s_rxBuf[3];
    uint16_t quantity  = ((uint16_t)s_rxBuf[4] << 8u) | s_rxBuf[5];

    if (quantity == 0u || quantity > MB_NUM_REGS)
    {
        sendException(0x10u, MB_EX_ILLEGAL_DATA_VALUE);
        return;
    }

    for(uint16_t i = 0;i<quantity;i++)
    {
    	if(! bIsAddValid(startAddr + i))
    	{
    		sendException(0x01u, MB_EX_ILLEGAL_DATA_ADDRESS);
    		return;
    	}
    }

    for (uint16_t i = 0u; i < quantity; i++)
    {
        uint16_t val = ((uint16_t)s_rxBuf[7u + (i * 2u)] << 8u)
                     | s_rxBuf[7u + (i * 2u) + 1u];
        Reg_t* pTmpReg = pFindReg(startAddr + i);
        if(pTmpReg != NULL)
        {
        	pTmpReg->u16Data = val;

    		/* store data to EEPROM */
    		uint8_t au8Tmp[2];
    		if(pTmpReg == &regUART_Param)
    		{
    			au8Tmp[0] = (uint8_t) pTmpReg->u16Data;
    			au8Tmp[1] = (uint8_t) (pTmpReg->u16Data >> 8);

    			if(EEPROM_enuWrite(cu16UART_PARAM_EE_ADD, au8Tmp, 2) == EEPROM_OK)
    			{
    				/* EEPROM write success */
    			}
    			else
    			{
    				/* TODO: handle this error */
    			}
    		}
    		else if(pTmpReg == &regDevAdd)
    		{
    			au8Tmp[0] = (uint8_t) pTmpReg->u16Data;
    			au8Tmp[1] = (uint8_t) (pTmpReg->u16Data >> 8);

    			if(EEPROM_enuWrite(cu16DEVICE_ADDRESS_EE_ADD, au8Tmp, 2) == EEPROM_OK)
    			{
    				/* EEPROM write success */
    			}
    			else
    			{
    				/* TODO: handle this error */
    			}
    		}
    		else
    		{
    			/* Ignore */
    		}
        }

        if((startAddr + i >= cu16RELAY_CON_CH_0_ADD) && (startAddr + i <= cu16RELAY_CON_CH_7_ADD))
		{
			// sync value with app layer
			bNewData = true;
		}
    }

    s_txBuf[0] = regDevAdd.u16Data;
    s_txBuf[1] = 0x10u;
    s_txBuf[2] = s_rxBuf[2];
    s_txBuf[3] = s_rxBuf[3];
    s_txBuf[4] = s_rxBuf[4];
    s_txBuf[5] = s_rxBuf[5];
    sendResponse(6u);
}

/* ── frame processor ────────────────────────────────────────────────────── */
static void processFrame(void)
{
#ifdef _DEBUG
	printf("Processing frame\r\n");
#endif

#ifdef _DEBUG
	printf("Frame data: 0x%x 0x%x 0x%x 0x%x 0x%x 0x%x 0x%x 0x%x\r\n", s_rxBuf[0], s_rxBuf[1], s_rxBuf[2], s_rxBuf[3], s_rxBuf[4], s_rxBuf[5], s_rxBuf[6], s_rxBuf[7]);
#endif

    /* minimum frame: addr(1) + fc(1) + data(min 4) + crc(2) = 8 bytes      */
    if (s_rxLen < 8u)
    {
#ifdef _DEBUG
    	printf("Processing frame: Len err, len: %d\r\n", s_rxLen);
#endif
        return;
    }

    /* address filter */
    if (s_rxBuf[0] != regDevAdd.u16Data)
    {
#ifdef _DEBUG
    	printf("Processing frame: Add err, rec add: %d, dev add: %d\r\n", s_rxBuf[0], regDevAdd.u16Data);
#endif
        return;
    }

    /* CRC check */
    uint16_t rxCrc   = ((uint16_t)s_rxBuf[s_rxLen - 1u] << 8u)
                      | s_rxBuf[s_rxLen - 2u];
    uint16_t calcCrc = crc16(s_rxBuf, s_rxLen - 2u);
    if (rxCrc != calcCrc)
    {
#ifdef _DEBUG
    	printf("Processing frame: crc err\r\n");
#endif
        return;
    }

    uint8_t fc = s_rxBuf[1];
    switch (fc)
    {
        case 0x01u:
#ifdef _DEBUG
        	printf("Processing frame, FC01\r\n");
#endif
        	fc01_readCoils();
        	break;
        case 0x05u:
#ifdef _DEBUG
        	printf("Processing frame, FC05\r\n");
#endif
        	fc05_writeSingleCoil();
        	break;
        case 0x0Fu:
#ifdef _DEBUG
        	printf("Processing frame, FC0F\r\n");
#endif
        	fc0F_writeMultipleCoils();
        	break;
        case 0x03u:
#ifdef _DEBUG
        	printf("Processing frame, FC03\r\n");
#endif
        	fc03_readHoldingRegs();
        	break;
        case 0x06u:
#ifdef _DEBUG
        	printf("Processing frame, FC06\r\n");
#endif
        	fc06_writeSingleReg();
        	break;
        case 0x10u:
#ifdef _DEBUG
        	printf("Processing frame, FC10\r\n");
#endif
        	fc10_writeMultipleRegs();
        	break;
        default:
#ifdef _DEBUG
        	printf("Processing frame, exc\r\n");
#endif
        	sendException(fc, MB_EX_ILLEGAL_FUNCTION);
        	break;
    }
}

/* ══════════════════════════════════════════════════════════════════════════
   Public API
   ══════════════════════════════════════════════════════════════════════════ */

/**
 * @brief Initialise Modbus slave.
 *        Call after timer_Init() and USART_Init().
 */
void Modbus_Init(void)
{
	/* Init EEPROM */
	EEPROM_vidInit();

	/* ************************************************************** */

	/* Init holding registers */
	/* Relay channels */
	regRelayCon0.u16Add = cu16RELAY_CON_CH_0_ADD;
	regRelayCon0.u16Data = RELAY_OFF;
	regRelayCon1.u16Add = cu16RELAY_CON_CH_1_ADD;
	regRelayCon1.u16Data = RELAY_OFF;
	regRelayCon2.u16Add = cu16RELAY_CON_CH_2_ADD;
	regRelayCon2.u16Data = RELAY_OFF;
	regRelayCon3.u16Add = cu16RELAY_CON_CH_3_ADD;
	regRelayCon3.u16Data = RELAY_OFF;
	regRelayCon4.u16Add = cu16RELAY_CON_CH_4_ADD;
	regRelayCon4.u16Data = RELAY_OFF;
	regRelayCon5.u16Add = cu16RELAY_CON_CH_5_ADD;
	regRelayCon5.u16Data = RELAY_OFF;
	regRelayCon6.u16Add = cu16RELAY_CON_CH_6_ADD;
	regRelayCon6.u16Data = RELAY_OFF;
	regRelayCon7.u16Add = cu16RELAY_CON_CH_7_ADD;
	regRelayCon7.u16Data = RELAY_OFF;

	regsRelCon.pRegs[0] = &regRelayCon0;
	regsRelCon.pRegs[1] = &regRelayCon1;
	regsRelCon.pRegs[2] = &regRelayCon2;
	regsRelCon.pRegs[3] = &regRelayCon3;
	regsRelCon.pRegs[4] = &regRelayCon4;
	regsRelCon.pRegs[5] = &regRelayCon5;
	regsRelCon.pRegs[6] = &regRelayCon6;
	regsRelCon.pRegs[7] = &regRelayCon7;

	regRelayConAll.u16Add = cu16RELAY_CON_ALL_ADD;
	regRelayConAll.u16Data = RELAY_OFF;

	/* Relay on delay */
	regRelayDelOn0.u16Add = cu16RELAY_ON_DELAY_CH_0_ADD;
	regRelayDelOn0.u16Data = cu16RELAY_DEFAULT_ON_DELAY;
	regRelayDelOn1.u16Add = cu16RELAY_ON_DELAY_CH_1_ADD;
	regRelayDelOn1.u16Data = cu16RELAY_DEFAULT_ON_DELAY;
	regRelayDelOn2.u16Add = cu16RELAY_ON_DELAY_CH_2_ADD;
	regRelayDelOn2.u16Data = cu16RELAY_DEFAULT_ON_DELAY;
	regRelayDelOn3.u16Add = cu16RELAY_ON_DELAY_CH_3_ADD;
	regRelayDelOn3.u16Data = cu16RELAY_DEFAULT_ON_DELAY;
	regRelayDelOn4.u16Add = cu16RELAY_ON_DELAY_CH_4_ADD;
	regRelayDelOn4.u16Data = cu16RELAY_DEFAULT_ON_DELAY;
	regRelayDelOn5.u16Add = cu16RELAY_ON_DELAY_CH_5_ADD;
	regRelayDelOn5.u16Data = cu16RELAY_DEFAULT_ON_DELAY;
	regRelayDelOn6.u16Add = cu16RELAY_ON_DELAY_CH_6_ADD;
	regRelayDelOn6.u16Data = cu16RELAY_DEFAULT_ON_DELAY;
	regRelayDelOn7.u16Add = cu16RELAY_ON_DELAY_CH_7_ADD;
	regRelayDelOn7.u16Data = cu16RELAY_DEFAULT_ON_DELAY;


	regsRelDelOn.pRegs[0] = &regRelayDelOn0;
	regsRelDelOn.pRegs[1] = &regRelayDelOn1;
	regsRelDelOn.pRegs[2] = &regRelayDelOn2;
	regsRelDelOn.pRegs[3] = &regRelayDelOn3;
	regsRelDelOn.pRegs[4] = &regRelayDelOn4;
	regsRelDelOn.pRegs[5] = &regRelayDelOn5;
	regsRelDelOn.pRegs[6] = &regRelayDelOn6;
	regsRelDelOn.pRegs[7] = &regRelayDelOn7;

	/* Relay off delay */
	regRelayDelOff0.u16Add = cu16RELAY_OFF_DELAY_CH_0_ADD;
	regRelayDelOff0.u16Data = cu16RELAY_DEFAULT_OFF_DELAY;
	regRelayDelOff1.u16Add = cu16RELAY_OFF_DELAY_CH_1_ADD;
	regRelayDelOff1.u16Data = cu16RELAY_DEFAULT_OFF_DELAY;
	regRelayDelOff2.u16Add = cu16RELAY_OFF_DELAY_CH_2_ADD;
	regRelayDelOff2.u16Data = cu16RELAY_DEFAULT_OFF_DELAY;
	regRelayDelOff3.u16Add = cu16RELAY_OFF_DELAY_CH_3_ADD;
	regRelayDelOff3.u16Data = cu16RELAY_DEFAULT_OFF_DELAY;
	regRelayDelOff4.u16Add = cu16RELAY_OFF_DELAY_CH_4_ADD;
	regRelayDelOff4.u16Data = cu16RELAY_DEFAULT_OFF_DELAY;
	regRelayDelOff5.u16Add = cu16RELAY_OFF_DELAY_CH_5_ADD;
	regRelayDelOff5.u16Data = cu16RELAY_DEFAULT_OFF_DELAY;
	regRelayDelOff6.u16Add = cu16RELAY_OFF_DELAY_CH_6_ADD;
	regRelayDelOff6.u16Data = cu16RELAY_DEFAULT_OFF_DELAY;
	regRelayDelOff7.u16Add = cu16RELAY_OFF_DELAY_CH_7_ADD;
	regRelayDelOff7.u16Data = cu16RELAY_DEFAULT_OFF_DELAY;


	regsRelDelOff.pRegs[0] = &regRelayDelOff0;
	regsRelDelOff.pRegs[1] = &regRelayDelOff1;
	regsRelDelOff.pRegs[2] = &regRelayDelOff2;
	regsRelDelOff.pRegs[3] = &regRelayDelOff3;
	regsRelDelOff.pRegs[4] = &regRelayDelOff4;
	regsRelDelOff.pRegs[5] = &regRelayDelOff5;
	regsRelDelOff.pRegs[6] = &regRelayDelOff6;
	regsRelDelOff.pRegs[7] = &regRelayDelOff7;


	uint8_t au8Tmp[2];
	/* UART parameters */
	regUART_Param.u16Add = cu16UART_PARAM_ADD;

	/* Read UART parameters from EEPROM */
	if(EEPROM_enuRead(cu16UART_PARAM_EE_ADD, au8Tmp, 2) == EEPROM_OK)
	{
		regUART_Param.u16Data = (au8Tmp[1] << 8) | au8Tmp[0];
	}

	/* Device address */
	regDevAdd.u16Add = cu16DEVICE_ADDRESS_ADD;
	/* default address in case no eeprom  read success*/
	regDevAdd.u16Data = 0x01;

	//if(EEPROM_enuRead(cu16DEVICE_ADDRESS_EE_ADD, au8Tmp, 2) == EEPROM_OK)
	{
		//regDevAdd.u16Data = (au8Tmp[1] << 8) | au8Tmp[0];
	}

	/* Software version */
	regSWVer.u16Add = cu16SOFTWARE_VERSION_ADD;
	regSWVer.u16Data = cu16SOFTWARE_VERSION;

/* ************************************************************** */

	/* Set device address */
	/* Read addr GPIO pins */
	uint8_t u8InputVal = 0x00;

	/* DIP switch pin becomes 0 when switched to "ON" position */
	/* logic here is reversed to make it normal to user */
	if(HAL_GPIO_ReadPin(ADD_0_GPIO_Port, ADD_0_Pin) == GPIO_PIN_SET)
		u8InputVal &= ~(1 << 0);
	else
		u8InputVal |= (1 << 0);

	if(HAL_GPIO_ReadPin(ADD_1_GPIO_Port, ADD_1_Pin) == GPIO_PIN_SET)
		u8InputVal &= ~(1 << 1);
	else
		u8InputVal |= (1 << 1);

	if(HAL_GPIO_ReadPin(ADD_2_GPIO_Port, ADD_2_Pin) == GPIO_PIN_SET)
		u8InputVal &= ~(1 << 2);
	else
		u8InputVal |= (1 << 2);

	if(HAL_GPIO_ReadPin(ADD_3_GPIO_Port, ADD_3_Pin) == GPIO_PIN_SET)
		u8InputVal &= ~(1 << 3);
	else
		u8InputVal |= (1 << 3);

	u8InputVal &= 0x0F;

	/* Parse value */
	if(u8InputVal == 0x00)
	{
		/* default to EEPROM address */
	}
	else if((u8InputVal > 0x00) && (u8InputVal < 0x10))
	{
		regDevAdd.u16Data = u8InputVal;
	}
	else
	{
		/* Unsupported address setting, ignore */
	}

#ifdef _DEBUG
	printf("Input value= %d\r\n", u8InputVal);
	printf("Dev Add= %d\r\n", regDevAdd.u16Data);
#endif

/* ************************************************************** */
	/* Read baud rate setting */
	uint32_t u32Baud = 9600; // default value

	/* Read baud GPIO pins */
	uint8_t u8BaudVal = 0x00;

	/* DIP switch pin becomes 0 when switched to "ON" position */
	/* logic here is reversed to make it normal to user */
	if(HAL_GPIO_ReadPin(BAUD_0_GPIO_Port, BAUD_0_Pin) == GPIO_PIN_SET)
		u8BaudVal &= ~(1 << 0);
	else
		u8BaudVal |= (1 << 0);

	if(HAL_GPIO_ReadPin(BAUD_1_GPIO_Port, BAUD_1_Pin) == GPIO_PIN_SET)
		u8BaudVal &= ~(1 << 1);
	else
		u8BaudVal |= (1 << 1);

	switch(u8BaudVal)
	{
	case 0x00:
		/* EEPROM */
		break;
	case 0x01:
		u32Baud = 19200;
		break;
	case 0x02:
		u32Baud = 57600;
		break;
	case 0x03:
		u32Baud = 115200;
		break;
	default:
		/* EEPROM */
		break;
	}

	/* Set uart baud rate */
	MODBUS_UART_HANDLE->Init.BaudRate = u32Baud;
	HAL_UART_Init(MODBUS_UART_HANDLE);

#ifdef _DEBUG
	printf("baud setting= %d\r\n", u8BaudVal);
	printf("baud rate= %lu\r\n", u32Baud);
#endif

/* ************************************************************** */

	ModbusTimer_vidInit(u32Baud);


/* ************************************************************** */

    s_rxLen = 0u;

    /* enable UART receive interrupt — 1 byte at a time */
    HAL_UART_Receive_IT(MODBUS_UART_HANDLE, &g_lastRxByte, 1u);
}

/* ══════════════════════════════════════════════════════════════════════════
   3.5T Inter-Frame Timer — TIM2
   ══════════════════════════════════════════════════════════════════════════
 *
 * TIM2 is a 16-bit general-purpose timer on APB1.
 *
 * Modbus RTU 3.5T inter-frame gap:
 *   baud <= 19200 → T35_us = (3.5 * 11 * 1e6) / baud
 *   baud >  19200 → T35_us = 1750 (fixed, per Modbus spec §2.5.1)
 *
 * Prescaler chosen so 1 tick = 1 us:
 *   PSC = (PCLK1_Hz / 1000000) - 1
 *   ARR = T35_us - 1   (timer fires after ARR+1 ticks)
 */

static uint32_t s_u32ArrValue = 0u;   /* cached ARR (3.5T in timer ticks) */

/**
 * @brief  Compute 3.5T inter-frame gap in microseconds for a given baud rate.
 */
static uint32_t u32CalcT35Us(uint32_t u32Baud)
{
    if (u32Baud <= 19200u)
    {
        /* 3.5 * 11 bits * 1e6 us/s = 38500000 */
        return 38500000u / u32Baud;
    }
    return 1750u;
}

/**
 * @brief  Initialise TIM2 for the 3.5T one-shot inter-frame timer.
 * @param  u32Baud  UART baud rate (Hz) used to compute the 3.5T window.
 *
 * Call once after MX_TIM2_Init() and before enabling UART RX interrupts.
 */
void ModbusTimer_vidInit(uint32_t u32Baud)
{
    uint32_t u32T35Us;
    uint32_t u32PclkHz;
    uint32_t u32Psc;

#ifdef _DEBUG
	printf("1. prescaler: %lu\r\n", htim2.Instance->PSC);
#endif

    u32T35Us  = u32CalcT35Us(u32Baud);
    u32PclkHz = HAL_RCC_GetPCLK1Freq();

#ifdef _DEBUG
	printf("timer 3.5T: %lu\r\n", u32T35Us);
#endif

    /* PSC chosen so each tick = 1 us → ARR ticks == microseconds */
    u32Psc = (u32PclkHz / 1000000u) - 1u;

    __HAL_TIM_SET_PRESCALER(&htim2, u32Psc);

    s_u32ArrValue = u32T35Us - 1u;   /* timer fires after ARR+1 ticks */

    if (s_u32ArrValue > 0xFFFFu)
        s_u32ArrValue = 0xFFFFu;     /* clamp to 16-bit TIM2 range */

    __HAL_TIM_SET_AUTORELOAD(&htim2, s_u32ArrValue);
    __HAL_TIM_SET_COUNTER(&htim2, 0u);

    /* Force PSC into the active shadow register immediately,
     * instead of waiting for the next natural update event. */
    HAL_TIM_GenerateEvent(&htim2, TIM_EVENTSOURCE_UPDATE);

    /* The UG event also sets UIF — clear it so we don't get
     * a spurious interrupt the moment Start_IT is called. */
    __HAL_TIM_CLEAR_FLAG(&htim2, TIM_FLAG_UPDATE);

#ifdef _DEBUG
	printf("2. prescaler: %lu\r\n", htim2.Instance->PSC);
#endif

    /* Do NOT start yet — wait for first RX byte */
}

/**
 * @brief  Restart the 3.5T one-shot window.
 *         Call on every received byte (extends the silence window).
 */
void ModbusTimer_Restart(void)
{
    __HAL_TIM_SET_COUNTER(&htim2, 0u);
    __HAL_TIM_CLEAR_FLAG(&htim2, TIM_FLAG_UPDATE);
    HAL_TIM_Base_Start_IT(&htim2);
}

/**
 * @brief  Stop the 3.5T timer (e.g. frame complete, or TX turnaround).
 */
void ModbusTimer_Stop(void)
{
    HAL_TIM_Base_Stop_IT(&htim2);
#ifdef _DEBUG
	printf("timer cnt: %lu\r\n", __HAL_TIM_GET_COUNTER(&htim2));
#endif
    __HAL_TIM_SET_COUNTER(&htim2, 0u);
}

/* ══════════════════════════════════════════════════════════════════════════ */
/* ══════════════════════════════════════════════════════════════════════════ */

/**
 * @brief Feed a received byte into the Modbus state machine.
 *        Call from HAL_UART_RxCpltCallback when huart->Instance == USART2.
 */
void Modbus_RxByteCallback(uint8_t byte)
{
	/* Turn RX led on */
	HAL_GPIO_WritePin(RX_LED_GPIO_Port, RX_LED_Pin, GPIO_PIN_RESET);

    /* restart 3.5T timer on every byte */
	/* On every received byte — restart 3.5T window */
	ModbusTimer_Restart();

    if (s_rxLen < MB_RX_BUF_SIZE)
        s_rxBuf[s_rxLen++] = byte;

    /* re-arm for next byte */
    HAL_UART_Receive_IT(MODBUS_UART_HANDLE, &g_lastRxByte, 1u);
}

/**
 * @brief Call from HAL_TIM_PeriodElapsedCallback when htim->Instance == TIM10.
 *        Signals 3.5T silence — frame is complete.
 */
void ModbusTimer_FrameDoneCallback(void)
{
	/* Explicit stop (e.g. during TX turnaround) */
	ModbusTimer_Stop();

#ifdef _DEBUG
	printf("Frame done\r\n");
#endif

    processFrame();
    s_rxLen = 0u;

    /* re-arm UART from start of buffer */
    HAL_UART_Receive_IT(MODBUS_UART_HANDLE, &g_lastRxByte, 1u);

	/* Turn RX led off */
	HAL_GPIO_WritePin(RX_LED_GPIO_Port, RX_LED_Pin, GPIO_PIN_SET);
}

void HAL_UART_TxCpltCallback(UART_HandleTypeDef *huart)
{
    if (huart->Instance == USART2)
    {
    	// Wait for shift register to fully empty
    	while (__HAL_UART_GET_FLAG(huart, UART_FLAG_TC) == RESET);
        RS485_DE_LOW();   // ← release bus after last byte is fully shifted out

    	/* Turn TX led off */
    	HAL_GPIO_WritePin(TX_LED_GPIO_Port, TX_LED_Pin, GPIO_PIN_SET);
    }
}
