Ahmed-Osama-v5/MBR-08/(commit log)

2026-06-04 feat: M08-4 Create scheduler skeleton - Added scheduler.h and scheduler.c files with basic structure. - Added Act LED task to main.c for testing scheduler functionality.
2026-06-04 feat: Create scheduler skeleton - Add task for modbus reception processing. - Add task for relay control processing.
2026-06-04 feat: Modbus frame forming - Updated modbus_slave.c to implement Modbus frame forming and parsing.
2026-06-04 feat: M08-7-Modbus-frame-forming - Added relay sync and control to app layer.
2026-06-06 feat: M08-10 Address-configuration - Address configuration for Modbus slave device based on DIP switch settings.
2026-06-06 feat: MB-08-8 Persistenet data management - Add i2c_eeprom module. - Get data from eeprom at initialization.
2026-06-06 feat: MB-08-8 Persistent Data Management - Store data to EEPROM for UART parameters and device address when using FC06 and FC10.
2026-06-12 Attach modbus RX callback to USART2 cbk
2026-06-14 feat: 10-implement-debug-uart - Implement debug uart over printf. - Replace LPTIM1 with TIM2. - Fix dev addr issue. - Add baud rate config. - Improve comm LEDs behaviour.
    [MBR-08_G0.ioc, main.c, main.h, modbus_slave.c, modbus_slave.h]
2026-06-14 update README.me and add schematics
